soonick/smart-fluid-flow-meter/frontend/README.md

# Backend

The front-end for `smart-fluid-flow-meter`. Uses SvelteKit

## Run

Start by creating a `.env` file:

```
cp .env.sample .env
```

Then proceed to fill the values according to your needs.

Start the development with:

```
make start
```
