soonick/smart-fluid-flow-meter/case/README.md

# Case

This folder contains the [FreeCAD](https://www.freecad.org/) models for the PCB cases.

There will be different versions depending on where the case will be placed.
