soonick/smart-fluid-flow-meter/case/indoor/case.FCStd

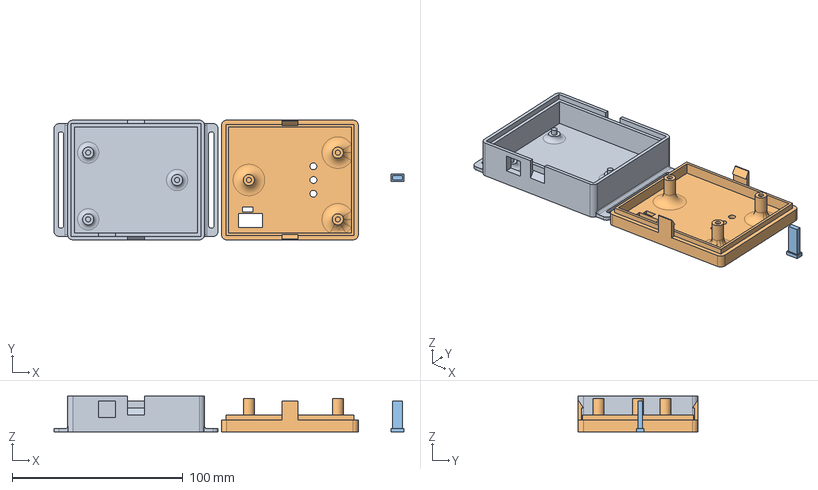
[picture p3: CAD file, 2024-12-26]
case/indoor/case.FCStd
204.7 x 70.0 x 21.0 mm
bottom_b
top_b
button_b
