soonick/smart-fluid-flow-meter/kicad/smart-fluid-flow-meter.kicad_pcb

## KiCad design kicad/smart-fluid-flow-meter.kicad_pcb (2025-01-03)

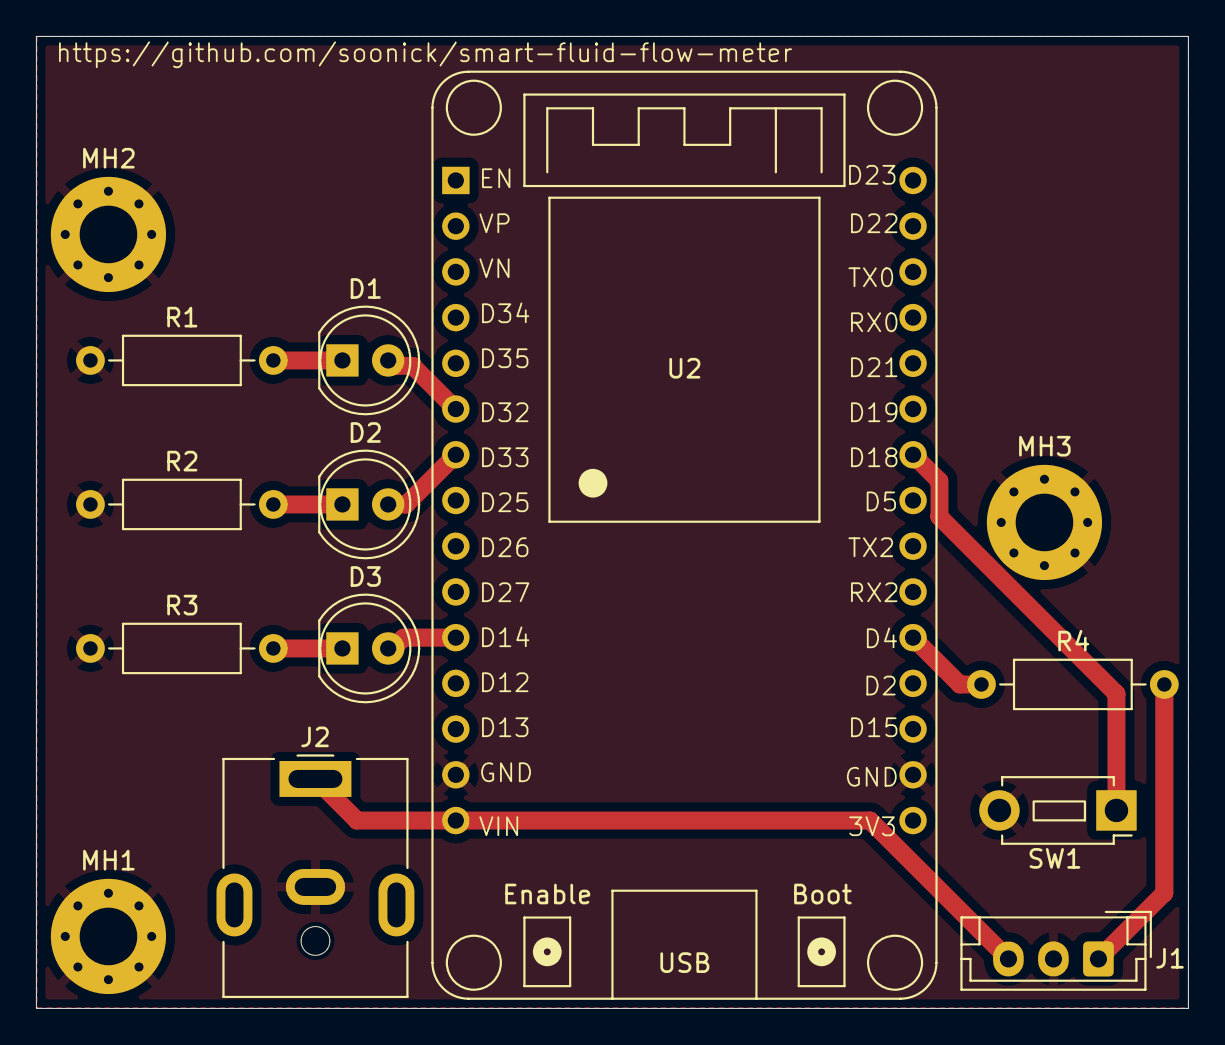
[picture p4: board smart-fluid-flow-meter.kicad_pcb from above]

Board: 2 copper layers, 64.0 x 54.0 mm, 14 parts (0 on the bottom side), 11 nets.

Parts:
D1: Green LED; LED_D5.0mm
D2: Yellow LED; LED_D5.0mm
D3: Red LED; LED_D5.0mm
J1: YF-S201; JST_EH_B3B-EH-A_1x03_P2.50mm_Vertical
J2: Barrel_Jack; BarrelJack_CUI_PJ-063AH_Horizontal
MH1, MH2, MH3: MountingHole_Pad; MountingHole_3.2mm_M3_Pad_Via
R1, R3: 220; R_Axial_DIN0207_L6.3mm_D2.5mm_P10.16mm_Horizontal
R2: 100; R_Axial_DIN0207_L6.3mm_D2.5mm_P10.16mm_Horizontal
R4: 3.3M; R_Axial_DIN0207_L6.3mm_D2.5mm_P10.16mm_Horizontal
SW1: Factory reset button; SW_PUSH_1P1T_6x3.5mm_H4.3_APEM_MJTP1243
U2: ESP32-DevkitV1; esp32_devkit_v1

Connections:
0: J1.2, J2.2, MH1.1, MH2.1, MH3.1, R1.1, R2.1, R3.1, SW1.2, U2.2 (GND), U2.29 (GND)
unnamed: D1.2 (A), U2.21 (D32)
unnamed: D1.1 (K), R1.2
unnamed: D2.2 (A), U2.22 (D33)
unnamed: D2.1 (K), R2.2
unnamed: D3.2 (A), U2.26 (D14)
unnamed: D3.1 (K), R3.2
unnamed: J1.1, R4.2
unnamed: J1.3, J2.1, U2.30 (VIN)
unnamed: R4.1, U2.5 (D4)
unnamed: SW1.1, U2.9 (D18)
