soonick/smart-fluid-flow-meter/(threads)

Thread 14 (2024-04-18):

Create network where user can input network credentials

soonick, 2024-04-18:

soonick, 2024-04-19:
Here is basically what we need: https://www.instructables.com/Avoid-Hard-Coding-WiFi-Credentials-on-Your-ESP8266/

soonick, 2024-04-19:
That library doesn't work with Arduino UNO R4 Wifi. This might be useful: https://www.elektroda.com/rtvforum/topic4000214.html

Closed 2024-06-26.

Thread 25 (2024-06-26):

Reset user configuration when a reset button is long pressed

soonick, 2024-06-26:

Closed 2024-07-05.

Thread 26 (2024-06-26):

Show in LEDs the current status of the system

soonick, 2024-06-26:
- AP is on
- Connected to configured network
- Configured but not connected
- Booting
- Resetting

soonick, 2024-07-23:
Connected to configured network: Green
AP mode: Yellow
Error connecting to network: Red
Booting/Resetting: Blinking all LEDs

Closed 2024-11-25.

Thread 36 (2024-07-23):

Wifi posts are super unreliable

soonick, 2024-07-23:

soonick, 2024-08-06:
Since we are moving to ESP32, this might change. I'll re-open if I find the same issue there

Closed 2024-08-06.

Thread 42 (2024-08-06):

[Arduino -> ESP32] Reset wifi credentials functionality

soonick, 2024-08-06:

Closed 2024-11-12.

Thread 66 (2024-11-20):

Investigate if there is a way to use low power mode and wake up from interrupt

soonick, 2024-11-20:

soonick, 2024-11-22:
Won't do as using battery doesn't seem to be an option for now

Closed 2024-11-22.

Thread 69 (2024-11-20):

Battery usage analysis

soonick, 2024-11-20:

soonick, 2024-11-20:
**Current measurements**

- Long sleep - 0.34 mA
- Wifi on. Sending https requests - 1.27 mA
- Access point on - 1.18 mA

My local supplier has these 3.7v LiPo batteries:

- 1000 mAh - 4 USD
- 2000 mAh - 8 USD

Which means, at maximum power consumption, the batteries would last approximately:

- 1000 mAh - 1 month
- 2000 mAh - 2 months

At minimum power consumption, the batteries would last approximately:

- 1000 mAh - 4 months
- 2000 mAh - 8 months

If I only use wifi every few hours, maybe I can get 6 moths for the large battery, but it still seems like too little autonomy. Deep sleep (if even possible) might add a nother couple of months, but 8 months still sounds like too little. I'll stick to a plugged solution for now.

soonick, 2024-11-20:
After some research, my previous measurements might be wrong. After checking the amp meter settings, I can see that with the wifi on and sending data, usage can get up to 160 mA.

This makes the autonomy even worse, so I'm just going to continue with a plugged solution.

Closed 2024-11-20.

Thread 77 (2024-11-25):

PCB improvements

soonick, 2024-11-25:
- Use wider traces
- GND plane / pour

After done, send PCB for review to https://www.reddit.com/r/PrintedCircuitBoard/ making sure to follow https://old.reddit.com/r/PrintedCircuitBoard/wiki/index#wiki_instructions_for_reviews

soonick, 2024-11-28:
Sent for review: https://www.reddit.com/r/PrintedCircuitBoard/comments/1h24an5/review_request_esp32devkitv1_with_water_flow/

Closed 2024-12-02.

Thread 80 (2024-11-25):

HTTPS requests sometimes fails

soonick, 2024-11-25:
It seems to be a recoverable error. This is a log:

```
E (21600716) smart-fluid-flow-meter: Sending request
I (21600756) wifi:wifi driver task: 3ffd4168, prio:23, stack:6656, core=0
I (21600766) wifi:wifi firmware version: ccaebfa
I (21600766) wifi:wifi certification version: v7.0
I (21600766) wifi:config NVS flash: enabled
I (21600776) wifi:config nano formating: disabled
I (21600776) wifi:Init data frame dynamic rx buffer num: 32
I (21600786) wifi:Init static rx mgmt buffer num: 5
I (21600786) wifi:Init management short buffer num: 32
I (21600786) wifi:Init dynamic tx buffer num: 32
I (21600796) wifi:Init static rx buffer size: 1600
I (21600796) wifi:Init static rx buffer num: 10
I (21600806) wifi:Init dynamic rx buffer num: 32
I (21600856) wifi_init: rx ba win: 6
I (21600856) wifi_init: accept mbox: 6
I (21600856) wifi_init: tcpip mbox: 32
I (21600856) wifi_init: udp mbox: 6
I (21600856) wifi_init: tcp mbox: 6
I (21600886) wifi_init: tcp tx win: 5760
I (21600886) wifi_init: tcp rx win: 5760
I (21600886) wifi_init: tcp mss: 1440
I (21600886) wifi_init: WiFi IRAM OP enabled
I (21600886) wifi_init: WiFi RX IRAM OP enabled
I (21600956) wifi:mode : sta (a0:dd:6c:0e:ef:80)
I (21600956) wifi:enable tsf
I (21600966) backend-service: Connecting to Chacmultun-13-2...
W (21600966) wifi:Password length matches WPA2 standards, authmode threshold changes from OPEN to WPA2
W (21600986) event: handler already registered, overwriting
I (21600996) wifi:new:<11,2>, old:<1,0>, ap:<255,255>, sta:<11,2>, prof:1, snd_ch_cfg:0x0
I (21600996) wifi:state: init -> auth (0xb0)
I (21601006) wifi:state: auth -> assoc (0x0)
I (21601016) wifi:state: assoc -> run (0x10)
I (21601036) wifi:connected with Chacmultun-13-2, aid = 3, channel 11, 40D, bssid = 14:cc:20:fd:13:d5
I (21601036) wifi:security: WPA2-PSK, phy: bgn, rssi: -72
I (21601036) wifi:pm start, type: 1

I (21601036) wifi:dp: 1, bi: 102400, li: 3, scale listen interval from 307200 us to 307200 us
I (21601096) wifi:AP's beacon interval = 102400 us, DTIM period = 1
I (21603146) wifi:<ba-add>idx:0 (ifx:0, 14:cc:20:fd:13:d5), tid:0, ssn:0, winSize:64
I (21604046) backend-service: Got IP address
I (21604046) esp_netif_handlers: sta ip: 192.168.1.198, mask: 255.255.255.0, gw: 192.168.1.254
I (21604796) esp-x509-crt-bundle: Certificate validated
I (21606106) backend-service: HTTP_EVENT_ON_CONNECTED
I (21606116) backend-service: HTTP_EVENT_HEADER_SENT
W (21611166) HTTP_CLIENT: Connection timed out before data was ready!
E (21611166) backend-service: Error with https request: ESP_ERR_HTTP_EAGAIN
I (21611166) backend-service: HTTP_EVENT_DISCONNECTED
I (21611226) backend-service: Turning off wifi
I (21611226) wifi:state: run -> init (0x0)
I (21611236) wifi:pm stop, total sleep time: 8248384 us / 10194646 us

I (21611236) wifi:<ba-del>idx:0, tid:0
I (21611236) wifi:new:<11,0>, old:<11,2>, ap:<255,255>, sta:<11,2>, prof:1, snd_ch_cfg:0x0
E (21611246) wifi:NAN WiFi stop
I (21611306) wifi:flush txq
I (21611306) wifi:stop sw txq
I (21611306) wifi:lmac stop hw txq
I (21611686) wifi:Deinit lldesc rx mblock:10
```

A link with some information: https://www.reddit.com/r/embedded/comments/1bo9rwh/connection_sometimes_times_out_in_esp32c3/

Closed 2024-11-25.

Thread 83 (2024-11-26):

ESP32 sometimes gets stuck in the middle of a request

soonick, 2024-11-26:
The green and yellow LEDs remain on and we this is the last thing in the logs:

```
E (7214246) smart-fluid-flow-meter: Request failed
I (7214286) wifi:wifi driver task: 3ffcb398, prio:23, stack:6656, core=0
I (7214296) wifi:wifi firmware version: ccaebfa
I (7214296) wifi:wifi certification version: v7.0
I (7214296) wifi:config NVS flash: enabled
I (7214296) wifi:config nano formating: disabled
I (7214306) wifi:Init data frame dynamic rx buffer num: 32
I (7214306) wifi:Init static rx mgmt buffer num: 5
I (7214316) wifi:Init management short buffer num: 32
I (7214316) wifi:Init dynamic tx buffer num: 32
I (7214326) wifi:Init static rx buffer size: 1600
I (7214326) wifi:Init static rx buffer num: 10
I (7214336) wifi:Init dynamic rx buffer num: 32
I (7214376) wifi_init: rx ba win: 6
I (7214376) wifi_init: accept mbox: 6
I (7214376) wifi_init: tcpip mbox: 32
I (7214376) wifi_init: udp mbox: 6
I (7214376) wifi_init: tcp mbox: 6
I (7214406) wifi_init: tcp tx win: 5760
I (7214406) wifi_init: tcp rx win: 5760
I (7214406) wifi_init: tcp mss: 1440
I (7214406) wifi_init: WiFi IRAM OP enabled
I (7214406) wifi_init: WiFi RX IRAM OP enabled
I (7214476) wifi:mode : sta (a0:dd:6c:0e:ef:80)
I (7214476) wifi:enable tsf
I (7214486) backend-service: Connecting to Chacmultun-13-2...
W (7214486) wifi:Password length matches WPA2 standards, authmode threshold changes from OPEN to WPA2
W (7214516) event: handler already registered, overwriting
I (7214556) wifi:new:<11,2>, old:<1,0>, ap:<255,255>, sta:<11,2>, prof:1, snd_ch_cfg:0x0
I (7214556) wifi:state: init -> auth (0xb0)
I (7214576) wifi:state: auth -> assoc (0x0)
I (7215576) wifi:state: assoc -> init (0x2700)
I (7215586) wifi:new:<11,0>, old:<11,2>, ap:<255,255>, sta:<11,2>, prof:1, snd_ch_cfg:0x0
```

soonick, 2024-11-26:
This happened when I left the device connected to my computer with the idf monitor on. I wonder if it might be caused by my computer going to sleep.

soonick, 2024-11-26:
It happened when I left the device connected to my computer without idf monitor, so the problem is not the monitor

soonick, 2024-11-27:
I have left the device connected for more than 24 hours, and it seems to be working fine. I suspect it might have something to do with the computer I was plugging it to going to sleep mode.

Closing this issue. I'll reopen if I notice it happens again.

Closed 2024-11-27.

Thread 122 (2024-12-26):

Make esp32 holes larger on PCB design

soonick, 2024-12-26:
The pins of the esp32 dev board are too thick compared to the holes for them, so it's very hard to insert the board in the PCB

Closed 2025-01-03.

Thread 134 (2024-12-29):

Firmware gets stuck on yellow LED

soonick, 2024-12-29:
It has happened a few times that the firmware gets stuck on the yellow LED. Need to figure out the reason and fix it

Closed 2024-12-31.

Thread 171 (2025-01-11):

Password reset flow

soonick, 2025-01-11:

Closed 2025-02-27.

Thread 184 (2025-01-17):

SameSite attribute for authorization cookie

soonick, 2025-01-17:
I'm getting this browser error:

Cookie “authorization” does not have a proper “SameSite” attribute value. Soon, cookies without the “SameSite” attribute or with an invalid value will be treated as “Lax”. This means that the cookie will no longer be sent in third-party contexts. If your application depends on this cookie being available in such contexts, please add the “SameSite=None“ attribute to it. To know more about the “SameSite“ attribute, read https://developer.mozilla.org/docs/Web/HTTP/Headers/Set-Cookie/SameSite

soonick, 2025-02-12:
Can't reproduce anymore

Closed 2025-02-12.
