soonick/smart-fluid-flow-meter/(commit log)

2024-04-07 Shell for rust backend. Fixes #1
    [main.rs]
2024-04-09 Endpoint that receives measures. Fixes #2
    [main.rs]
2024-04-10 Return custom errors on failures. Fixes #7
    [main.rs]
2024-04-10 Split project into different modules and folders. Fixes #9
    [main.rs]
2024-04-10 Save measurements to MySQL database. Fixes #4
    [main.rs, storage.rs]
2024-04-11 Save measurementes to firestore. Fixes #5
    [main.rs, storage.rs]
2024-04-18 Configuration management. Fixes #6
    [lib.rs, main.rs]
2024-04-18 Log all requests. Fixes: #8
    [lib.rs, main.rs]
2024-04-18 Arduino sketch skeleton. Fixes #13
    [sketch.ino]
2024-04-18 Build Arduino Sketch on CI. Fixes #15
2024-05-11 Include Arduino.h in main.cpp
2024-06-28 Reset device settings if button is long pressed
2024-07-05 Connect to WiFi once board is correctly set up
2024-07-07 Read flow from sensor. Fixes #17
2024-07-23 [sketch] Post sensor data to the backend. Fixes #18 (#37)
2024-07-23 [sketch] Add led on indicator. #26 (#38)
2024-10-01 [esp32] Treat all warnings as errors (#46)
2024-10-01 [esp32] First commit for wifi-manager. Sets up AP and serves hello world (#47)
2024-11-01 Update main readme. Remove sketch link, add esp32 link (#50)
2024-11-01 Created kicad folder (#51)
    [smart-fluid-flow-meter.kicad_pcb, smart-fluid-flow-meter.kicad_sch]
2024-11-02 Add power LED and yf-s201 to kicad schematic (#52)
    [smart-fluid-flow-meter.kicad_sch]
2024-11-02 Power LED (#49)
2024-11-05 [esp32] Move source code to src folder (#53)
2024-11-09 Add resistors to water flow meter in schematic. Add notes to schematic (#54)
    [smart-fluid-flow-meter.kicad_sch]
2024-11-10 Replace 6 1MOhm resistors with 2 3.3MOhm resistors in schematic (#55)
    [smart-fluid-flow-meter.kicad_sch]
2024-11-10 Add factory reset button (#56)
    [smart-fluid-flow-meter.kicad_sch]
2024-11-10 Turn on power LED (#57)
    [smart-fluid-flow-meter.kicad_sch]
2024-11-13 [esp32] Read measurements from flow meter (#62)
    [smart-fluid-flow-meter.kicad_sch]
2024-11-20 Add status LEDs to kicad. #26 (#70)
    [smart-fluid-flow-meter.kicad_sch]
2024-11-20 Add spice model propererties to some symbols (#71)
    [smart-fluid-flow-meter.kicad_sch]
2024-11-22 Design PCB (#74)
    [smart-fluid-flow-meter-B_Cu.gbr, smart-fluid-flow-meter-B_Mask.gbr, smart-fluid-flow-meter-B_Silkscreen.gbr, smart-fluid-flow-meter-Edge_Cuts.gbr, smart-fluid-flow-meter-F_Cu.gbr, smart-fluid-flow-meter-F_Mask.gbr, smart-fluid-flow-meter-F_Silkscreen.gbr, smart-fluid-flow-meter-NPTH.drl]
2024-11-22 Remove smart-fluid-flow-meter folder inside of kicad folder (#75)
    [smart-fluid-flow-meter-B_Cu.gbr, smart-fluid-flow-meter-B_Mask.gbr, smart-fluid-flow-meter-B_Silkscreen.gbr, smart-fluid-flow-meter-Edge_Cuts.gbr, smart-fluid-flow-meter-F_Cu.gbr, smart-fluid-flow-meter-F_Mask.gbr, smart-fluid-flow-meter-F_Silkscreen.gbr, smart-fluid-flow-meter-NPTH.drl]
2024-11-25 [esp32] Move backend URL to constant (#78)
2024-11-25 LEDs turn in different ways depending on the state of the system. Fixes #26 (#79)
2024-11-25 Remove sketch folder. We use ESP32 now (#81)
2024-11-27 Fix Electrical Rules Checker errors. Fixes #73 (#87)
    [smart-fluid-flow-meter.kicad_sch]
2024-11-27 Wider traces and ground plane. #77 (#88)
    [smart-fluid-flow-meter.kicad_pcb]
2024-11-28 [kicad] Use the gnd plane for gnd connections (#89)
    [smart-fluid-flow-meter.kicad_pcb]
2024-11-28 [kicad] Update gerbers (#91)
    [smart-fluid-flow-meter-B_Cu.gbr, smart-fluid-flow-meter-B_Mask.gbr, smart-fluid-flow-meter-B_Silkscreen.gbr, smart-fluid-flow-meter-Edge_Cuts.gbr, smart-fluid-flow-meter-F_Cu.gbr, smart-fluid-flow-meter-F_Mask.gbr, smart-fluid-flow-meter-F_Silkscreen.gbr, smart-fluid-flow-meter-job.gbrjob]
2024-12-02 First prototype of bottom case. #92 (#93)
    [case.FCStd]
2024-12-03 First prototype of top case. #92 (#94)
    [case.FCStd]
2024-12-03 Remove gerbers since they can be generated from pcb design file (#95)
    [smart-fluid-flow-meter-B_Cu.gbr, smart-fluid-flow-meter-B_Mask.gbr, smart-fluid-flow-meter-B_Silkscreen.gbr, smart-fluid-flow-meter-Edge_Cuts.gbr, smart-fluid-flow-meter-F_Cu.gbr, smart-fluid-flow-meter-F_Mask.gbr, smart-fluid-flow-meter-F_Silkscreen.gbr, smart-fluid-flow-meter-NPTH.drl]
2024-12-03 Add holes to top cover. #92 (#96)
    [case.FCStd]
2024-12-04 Create windows for led pipes. #92 (#97)
    [case.FCStd]
2024-12-05 [case] Button extension. Fixes #99 (#102)
    [case.FCStd]
2024-12-06 [case] Clips for securing to and bottom together. Fixes #98 (#103)
    [case.FCStd]
2024-12-06 [esp32] Bump wifi-manager. Fixes #104 (#105)
2024-12-07 [case] Update holes to match received parts (#112)
    [case.FCStd]
2024-12-15 [case] Create folder for indoor case. Made modifications and added assembly section (#116)
    [case.FCStd]
2024-12-26 [esp32] Tune flow sensor conversion factor (#120)
2024-12-26 [case] Update some measurements so case closes more easily (#121)
    [case.FCStd]
2024-12-28 [backend] Discard duplicate measurements sent by clients. Fixes #123 (#125)
    [storage.rs]
2024-12-28 [backend][esp32] Rename measure to measurement. Fixes #131 (#132)
    [lib.rs]
2024-12-29 [backend] When using firestore use a document-id based on device id and timestamp to prevent duplicates. Fixes #123 (#133)
2024-12-31 [esp32] Release http request semaphore even if we can't get an IP. Fixes #134 (#136)
2025-01-02 Update circleci deploy key fingerprint (#146)
2025-01-03 [backend] Add captcha secret to .env.sample (#148)
2025-01-03 [kicad] Make esp32 holes larger. Fixes #122 (#149)
    [smart-fluid-flow-meter.kicad_pcb]
